hellodk34/MotoNav-CYD-Plus/坡度算法.md

# 坡度算法说明

本文说明 MotoNav-CYD-Plus 中「坡度」（Grade）的计算原理、数据来源、实现流程与精度局限，对应源码 `MotoNav-CYD-Plus.ino` 中 `updateGradeWindow()`、`computeGradePercent()`、`gradeText()` 等函数，以及 `config.h` 中 `GRADE_*` 常量。

---

## 1. 设计目标

- 行驶中实时显示道路坡度，可选「百分比」或「角度」两种单位（`PERCENT` / `DEGREES`，另可 `OFF` 关闭）。
- 坡度要**稳**：不能像早期版本那样因气压/位置抖动而频繁乱跳，更不能出现「实际 2° 却显示 16°」这种离谱尖峰。
- 停车（坡道驻车）时**冻结显示最后一段的坡度**，而不是立刻变成 `--`。

---

## 2. 为什么用「时间域 Vz/Vh」，而不是「距离域回归」

坡度本义是 **垂直位移 ÷ 水平位移**。实现上有两条路：

1. **距离域**：看「最近 N 米水平距离内海拔变化了多少」。这是上一版的做法。
2. **时间域 Vz/Vh**：垂直速度 Vz（m/s）÷ 水平速度 Vh（m/s）。这是 Garmin / 迈金 / 行者等**码表厂家的同款架构**。

上一版（距离域）暴露了一个致命缺陷，也是「16° 离谱值」的直接来源：

> 停车时气压海拔持续漂移（车内气压随开关门、阵风、温度等缓慢变化，30 秒可漂 0.3~1 m）。起步后只要前进 1 m 就满足采样间距，于是 `0.3 m ÷ 1 m = 30% ≈ 16.7°`。城市走走停停必触发。

而**时间域 Vz/Vh** 天然规避了它：

- 漂移被均摊到「每秒」里：停车 30 秒漂 0.3 m，Vz 只有 0.01 m/s，不再是 0.3 m/1 m。
- 停车时 Vh → 0，直接用**速度门控冻结**，不参与除法，绝不放大成尖峰。

早期版本弃用「瞬时 Vz/Vh」是因为两个问题，本版用对应手段逐个解决：

| 早期 Vz/Vh 的问题 | 本版解决办法 |
|---|---|
| 分母为 0（停车时 Vh≈0，除法无意义） | **Vh 门控**：Vh < `GRADE_MIN_VH_KMH` 时不计算，直接冻结显示 |
| 瞬时抖动大（气压海拔短时噪声） | **海拔中值滤波** + **15s 时间窗最小二乘回归** + **输出 EMA 平滑** |

---

## 3. 数据来源

| 数据 | 来源 | 用途 |
|---|---|---|
| 海拔 | 融合海拔（气压相对海拔，见《海拔算法.md》） | 求垂直速度 Vz |
| 水平速度 Vh | GNSS 多普勒速度（`filteredSpeedKmh`） | 求坡度比值 + 门控 |
| 时间 | `millis()` | 时间窗回归的自变量 |

> 坡度只关心**海拔的相对变化**，与绝对海拔无关，所以直接用「气压相对海拔」`baroAltitudeM` 即可，不依赖 GNSS 绝对锚定是否完成（锚定偏移 `baroOffsetM` 只平移绝对值，不影响斜率）。

---

## 4. 算法流程

### 4.1 中值滤波 + 采样（`updateGradeWindow`）

固定周期（`GRADE_SAMPLE_INTERVAL_MS`，250 ms）执行：

1. 取当前融合海拔（优先 `baroAltitudeM`，无 BMP 则退 GNSS 海拔）。
2. **3 点中值滤波**：压车内气压短时尖峰（开关门、阵风等单个坏点）。
3. **移动判定**：多普勒速度 ≥ `GRADE_MIN_VH_KMH`（3.0 km/h）才把 `{时间, 中值海拔}` 写入 128 点环形缓冲；否则只更新中值滤波状态、不写缓冲。

> 停车时第 3 步不写缓冲 → 窗口内没有新的停车样本 → 坡度不会被气压漂移污染；恢复行驶后旧样本随时间自然滑出窗口。

### 4.2 时间窗最小二乘回归（`computeGradePercent`）

每次刷新显示时：

1. **Vh 门控**：`filteredSpeedKmh() < GRADE_MIN_VH_KMH` → 直接返回 false（冻结，不更新）。
2. 取最近 `GRADE_WINDOW_S`（15 s）内的采样点，对「海拔 vs 时间」做线性回归，斜率即**垂直速度 Vz（m/s）**：
   ```
   Vz = (n·Σty − Σt·Σy) / (n·Σt² − (Σt)²)
   ```
3. **物理限幅**：|坡度| > `GRADE_MAX_PERCENT`（40%）视为异常丢弃。
4. **输出 EMA 平滑**：`gradeSmoothedPct += GRADE_OUTPUT_ALPHA × (rawPct − gradeSmoothedPct)`。
5. 最终 `坡度% = Vz / Vh × 100`。

> 回归前把坐标轴平移（时间减窗口起点、海拔减首个样本），避免大数相减丢精度；窗口内约 60 个点（15 s × 4 Hz），随机噪声按 ~1/√N 互相抵消。

### 4.3 显示量化（`gradeText`）

- 坡度 % 与 ° 之间换算：`角度 = atan(坡度% / 100)`。
- **整数显示**：四舍五入到整数（`round`）。
- **显示迟滞**：整数只在连续值越过整数边界并留出 `GRADE_DISPLAY_HYSTERESIS` 死区后才更新，避免坡度恰好在 0°/1° 等边界附近来回跳。
- **符号规则**（对齐比亚迪 DiLink 车机观感）：正数不带 `+`、负数带 `-`、零无号。
  - 百分比：`6%`、`0%`、`-3%`
  - 角度：`3°`、`0°`、`-2°`
- **冻结逻辑**：`computeGradePercent` 返回 false 时（低速/静止），若此前已产生过有效坡度（`gradeHasValue`），则继续显示最后一次平滑值；若从未产生过，则显示 `--`。

---

## 5. 关键参数（`config.h`）

| 常量 | 默认 | 说明 |
|---|---:|---|
| `GRADE_WINDOW_S` | 15.0 | Vz 回归窗口（秒）。越大越稳、越滞后 |
| `GRADE_SAMPLE_INTERVAL_MS` | 250 | 海拔采样周期（4 Hz） |
| `GRADE_MIN_VH_KMH` | 3.0 | 水平速度门控，低于此值冻结显示 |
| `GRADE_MIN_SAMPLES` | 8 | 窗口内最少采样点数（约 2 s@4 Hz） |
| `GRADE_MAX_PERCENT` | 40.0 | 物理限幅，超此值视为异常丢弃 |
| `GRADE_OUTPUT_ALPHA` | 0.25 | 输出坡度 EMA 平滑系数 |
| `GRADE_DISPLAY_HYSTERESIS` | 0.2 | 整数显示迟滞死区（显示单位：°或%，抑制 0↔1 边界跳变） |

> 建议范围：`GRADE_WINDOW_S` 取 10 ~ 20 s。想要更跟手降到 10，想要更稳/更抗抖提到 20；`GRADE_MIN_VH_KMH` 取 3 ~ 4 km/h 都能有效抑制起步尖峰。

---

## 6. 行为一览

| 场景 | 显示 |
|---|---|
| 匀速/正常行驶 | 稳定的整数坡度（`6%` / `3°`） |
| 坡道停车 | **冻结显示最后一次有效坡度**，不再 `--`，也不出现尖峰 |
| 刚起步（窗口内 < 8 点） | `--` |
| 无气压计且无 GNSS 海拔 | `--` |
| GNSS 失锁 / 低速 | 冻结，继续显示最后坡度（不漂移） |
| 坡度风格 OFF | 不显示 |

---

## 7. 精度与局限（务必知悉）

- **显示的是「最近约 15 秒内道路的坡度」，不是「车身此刻的真实倾角」**。
  - 在长且均匀的坡上停车 → 很准，观感接近车机原厂的 2°。
  - 从平路开到坡脚刚停下 → 显示的是平路的 0，而不是眼前坡的度数。
- 精度约 **±0.5 ~ 1°** 量级，属于「大致对、够参考」：
  - 气压海拔短期相对变化很准，但仍有约 ±0.2 m 的短期噪声；
  - 窗口越长噪声压得越低，但滞后越明显。
- **为什么做不到比亚迪那种「静止也测车身倾角」**：比亚迪用的是**加速度计 / IMU**，静止时直接测重力矢量相对车身的倾角，与运动状态无关。本设备只有 **BMP280 气压计 + GNSS**：
  - 气压计只测气压（→高度），不包含任何「倾斜」信息，静止时垂直速度为 0；
  - GNSS 静止时没有新的水平位移。
  - 因此「实时」计算停车点的坡度在物理上无解，本版用「冻结最近路段坡度」做近似。要真正突破，只能加装 IMU（如 MPU6050 / ADXL345 / LSM6DS3 等），属于硬件改动。

---

## 8. 相关代码位置

| 函数 / 常量 | 位置 |
|---|---|
| `updateGradeWindow()` | `MotoNav-CYD-Plus.ino` |
| `computeGradePercent()` | `MotoNav-CYD-Plus.ino` |
| `gradeText()` / `drawGradeValue()` | `MotoNav-CYD-Plus.ino` |
| `gradeAltitudeM()` | `MotoNav-CYD-Plus.ino` |
| `GRADE_WINDOW_S` 等常量 | `config.h` |
