hellodk34/MotoNav-CYD-Plus/海拔算法.md

# 海拔算法说明

本文说明 MotoNav-CYD-Plus 中海拨（Altitude）的计算原理，重点是**「GNSS 绝对基准慢锚定 + 气压相对变化」融合**。对应源码 `MotoNav-CYD-Plus.ino` 中 `initializeBaro()`、`updateBaro()`、`altitudeText()`、`gpxAltitudeMeters()`，以及 `config.h` 中 `BARO_*` / `ALT_*` / `SEA_LEVEL_HPA` 等常量。

---

## 1. 两种海拔数据源

本设备同时拥有两个可以推算海拔的传感器，它们的特性正好互补：

| 数据源 | 原理 | 优点 | 缺点 |
|---|---|---|---|
| **GNSS 海拔** | 卫星解算的椭球高/大地高 | 绝对正确，长期稳定、无漂移 | 噪声大（垂直误差通常 ±3~5 m，甚至更多）、更新慢、需要良好定位 |
| **BMP280 气压海拔** | 气压 → 标准大气模型换算 | 短期相对变化非常平滑、即时，分辨率高 | 只是「相对」海拔，随天气/温度漂移，需要基准 |

- **GNSS 绝对正确但抖**：适合做「基准」，慢慢把气压海拔拉回正确绝对高度。
- **气压平滑且即时**：适合做「变化量」，让显示的海拔、垂直速度、坡度都平滑跟手。

两者结合，就得到「既平滑又绝对正确」的融合海拔。

---

## 2. 气压海拔（BMP280 相对海拔）

BMP280 通过 I2C 读取（地址自动探测 0x76 / 0x77），工作参数在 `initializeBaro()` 中设置：

```
MODE_NORMAL, SAMPLING_X2(温度), SAMPLING_X8(气压), FILTER_X8, STANDBY_MS_1
```

每 `BARO_READ_INTERVAL_MS`（100 ms）读一次，在 `updateBaro()` 中处理：

1. 读温度与气压：`rawAlt = bmp.readAltitude(SEA_LEVEL_HPA)`。
   - `SEA_LEVEL_HPA = 1013.25`（标准海平面气压），是相对海拔的参考基准。想改成你常驻地的当地平均气压可调，但对**相对变化**不影响。
   - 温度可加 `TEMP_OFFSET_C` 补偿（默认 0，发现系统性偏差再改）。
2. **合理性校验**（防 I2C 偶发干扰读到垃圾值）：温度超出 `[-50, +100]`°C、海拔超出 `[-1000, +10000]` m、或 NaN/Inf，整次丢弃，不污染后续滤波与 GPX。
3. **低通滤波**：`baroAltitudeM += BARO_ALT_ALPHA × (rawAlt − baroAltitudeM)`，`BARO_ALT_ALPHA = 0.15`，平滑短时气压波动。

得到的 `baroAltitudeM` 是「**平滑后的相对海拔**」，短期变化准，但绝对值会随天气缓慢漂移。

> **失效检测（自动降级）**：固件统计「连续读失败」次数（`baroConsecutiveFails`）。连续 `BARO_FAULT_THRESHOLD`（30 次 ≈ 3 秒）都读到非法值，就判定传感器失效（`baroHealthy()` 为 false），此时屏幕温度/坡度显示 `--`、海拔回退 GNSS、GPX 停止写气压融合值；一旦读到有效值立即恢复，**无需重启**。这样暴晒过热导致传感器假死时，屏上显示的是诚实的 `--`，而不是初始的 `0`。

---

## 3. GNSS 绝对海拔

来自 `gps.altitude.meters()`。只有当 GNSS 定位良好时才可信，本项目要求同时满足：

```
gps.altitude.isValid()
gps.hdop.isValid() && gps.hdop.hdop() < MAX_HDOP_FOR_DISTANCE   // 4.0
```

且海拔值需落在 `[-1000, +10000]` m 内、有限。满足这些条件的 GNSS 海拔，才能参与「锚定」。

---

## 4. 融合：GNSS 慢锚定 + 气压相对变化

融合的核心是一个**偏移量** `baroOffsetM`，把「气压相对海拔」平移成「绝对海拔」：

```
融合海拔 = baroAltitudeM + baroOffsetM
```

`baroOffsetM` 的维护逻辑在 `updateBaro()` 中：

1. **首次锚定**（`baroAnchorSet == false`）：当第一次遇到质量良好的 GNSS 海拔时，直接令
   ```
   baroOffsetM = gpsAlt − baroAltitudeM
   baroAnchorSet = true
   ```
   这样融合海拔瞬间等于 GNSS 绝对海拔，消除气压基准的初始偏差。

2. **后续慢校正**（已锚定）：此后用极慢的系数逐步微调偏移，吸收气压的缓慢漂移：
   ```
   fused = baroAltitudeM + baroOffsetM
   baroOffsetM += BARO_GNSS_ANCHOR_ALPHA × (gpsAlt − fused)   // BARO_GNSS_ANCHOR_ALPHA = 0.01
   ```
   `0.01` 意味着「误差的 1% / 每次」，等效一个时间常数很长的低通：GNSS 的抖动基本被过滤掉，只把长期趋势慢慢灌进去。

**为什么这样设计**：如果直接显示 GNSS 海拔，会抖得没法看；如果只用气压海拔，绝对值会漂。用「气压提供高频（变化）+ GNSS 提供低频（基准）」，正好各取所长。这跟很多高度表/飞控的「互补滤波」思路一致。

---

## 5. 显示与写入路径

融合结果在两条路径中使用，规则略有不同：

### 5.1 屏幕显示（`altitudeText`）

```
if (!haveAltitude()) return "--";                     // 气压计不可用且无 GNSS 海拔
alt = baroHealthy() ? (baroAltitudeM + baroOffsetM)   // 气压计可用：用融合值
                    : gps.altitude.meters();          // 气压计不可用：回退 GNSS 海拔
if (alt 非法/超范围) return "--";
显示 round(alt) + " m"                                // 整数米
```

- 气压计可用（`baroHealthy()`）时**始终用融合值**（即使还没锚定，此时 `baroOffsetM = 0`，相当于直接显示气压相对海拔）。
- 气压计不可用（失效/未就绪）时回退到 **GNSS 海拔**（会偏抖，但可用）。

### 5.2 GPX `<ele>` 写入（`gpxAltitudeMeters`）

GPX 要保证合法可导入，所以更严格：

```
优先：baroHealthy() && baroAnchorSet  →  baroAltitudeM + baroOffsetM
否则：gps.altitude.isValid()          →  gps.altitude.meters()
数值有限且在 [-1000, +10000] 内才写入 <ele>，否则该点不写 <ele>
```

> 关键区别：GPX 写 `baroAltitudeM + baroOffsetM` **必须等 `baroAnchorSet` 为真**——即必须先锚定，否则写进 GPX 的可能是没对齐基准的相对海拔，绝对数值是错的。而屏幕显示可以更宽松（未锚定也能先显示相对值）。
>
> 与屏幕显示一致：气压计不可用时，GPX 同样会**尽最大努力回退到 GNSS 海拔**写 `<ele>`；只有两者都拿不到合法数值时才不写 `<ele>`（该点依然合法）。

---

## 6. 温度

BMP280 顺带提供温度，经同样的合理性校验后显示在屏幕右上角（整数 °C，无小数）：

```
baroTemperatureC = readTemperature() + TEMP_OFFSET_C
温度超 [-50, +100]°C 或 NaN → 丢弃，显示 "--"
```

温度仅作显示，不参与海拔/坡度计算（气压海拔由库内部按温度做了补偿，属于库行为）。

---

## 7. 关键参数（`config.h`）

| 常量 | 默认 | 说明 |
|---|---:|---|
| `SEA_LEVEL_HPA` | 1013.25 | 相对海拔参考气压（只影响绝对值，不影响变化量） |
| `TEMP_OFFSET_C` | 0.0 | 温度补偿（发现系统性偏差再改） |
| `BARO_READ_INTERVAL_MS` | 100 | BMP280 采样周期 |
| `BARO_ALT_ALPHA` | 0.15 | 气压海拔低通系数（越大越跟手、越抖） |
| `BARO_GNSS_ANCHOR_ALPHA` | 0.01 | GNSS 绝对海拔慢锚定系数（越小越慢、越抗抖） |
| `BARO_FAULT_THRESHOLD` | 30 | 连续读失败多少次判定传感器失效（100ms×30≈3s） |
| `BARO_MIN_TEMP_C` / `BARO_MAX_TEMP_C` | -50 / 100 | 温度合理范围（超出丢弃） |
| `ALT_MIN_M` / `ALT_MAX_M` | -1000 / 10000 | 海拔合理范围（超出丢弃） |
| `MAX_HDOP_FOR_DISTANCE` | 4.0 | GNSS 海拔参与锚定的 HDOP 门槛 |

---

## 8. 局限与注意

1. **锚定需要时间**：开机后要等 GNSS 定位良好（HDOP < 4）才会完成首次锚定；在此之前显示的是气压相对海拔（绝对数值可能差几十米，属正常，等锚定后自动校正）。
2. **天气漂移**：气压随天气变化，长时间（几十分钟以上）不移动时，即使已锚定，融合海拔也会缓慢漂。GNSS 慢锚定能纠正，但纠正很慢。
3. **I2C 偶发干扰**：读到离谱值（182°C、-nan、超大/负海拔）会被整次丢弃，显示 `--`、GPX 不写 `<ele>`。若 `--` 频繁，检查 SDA/SCL 布线（短、双绞、远离大电流）。
4. **暴晒过热假死**：长时间直晒使模块温度超过 +85°C 时，传感器测量部分可能失效（芯片 ID 仍能读，故固件仍认为它「就绪」），此时读数非法、连续失败超阈值，自动降级为 `--`（温度/坡度）并回退 GNSS 海拔；冷却后自动恢复。物理上务必把 BMP280 放到遮阴通风、不贴玻璃/黑仪表台的位置。
5. **无 BMP280 时**：海拔回退纯 GNSS，坡度/温度显示 `--`，其余功能不受影响。

---

## 9. 相关代码位置

| 函数 / 常量 | 位置 |
|---|---|
| `initializeBaro()` / `updateBaro()` | `MotoNav-CYD-Plus.ino` |
| `altitudeText()` | `MotoNav-CYD-Plus.ino` |
| `gpxAltitudeMeters()` | `MotoNav-CYD-Plus.ino` |
| `haveAltitude()` | `MotoNav-CYD-Plus.ino` |
| `BARO_*` / `ALT_*` / `SEA_LEVEL_HPA` 常量 | `config.h` |
