hellodk34/MotoNav-CYD-Plus/(commit log)

2026-11-09 Initial commit: MotoNav-CYD-Plus
    Fork of markseder/MotoNav-CYD (MIT, Copyright 2026 Pavel Matveev).
    Additions over upstream V1.1.2:
    - ST7789 / CYD2USB (ESP32-2432S028R) hardware adaptation
    - BMP280 altimeter / grade / temperature
    - Speedo range raised to 240 km/h, three-zone color
    - WiFi provisioning + automatic GPX upload (TRACKS + WebDAV) with ntfy push
    Endpoints and API keys are placeholders; see secret.h.example.
2026-11-09 feat: use custom track name for GPX file, update doc and code
